muccc/moodlamp-rf/board/buslamp-r4_reverse_ESP.brd

## EAGLE design board/buslamp-r4_reverse_ESP.brd (2017-02-21)

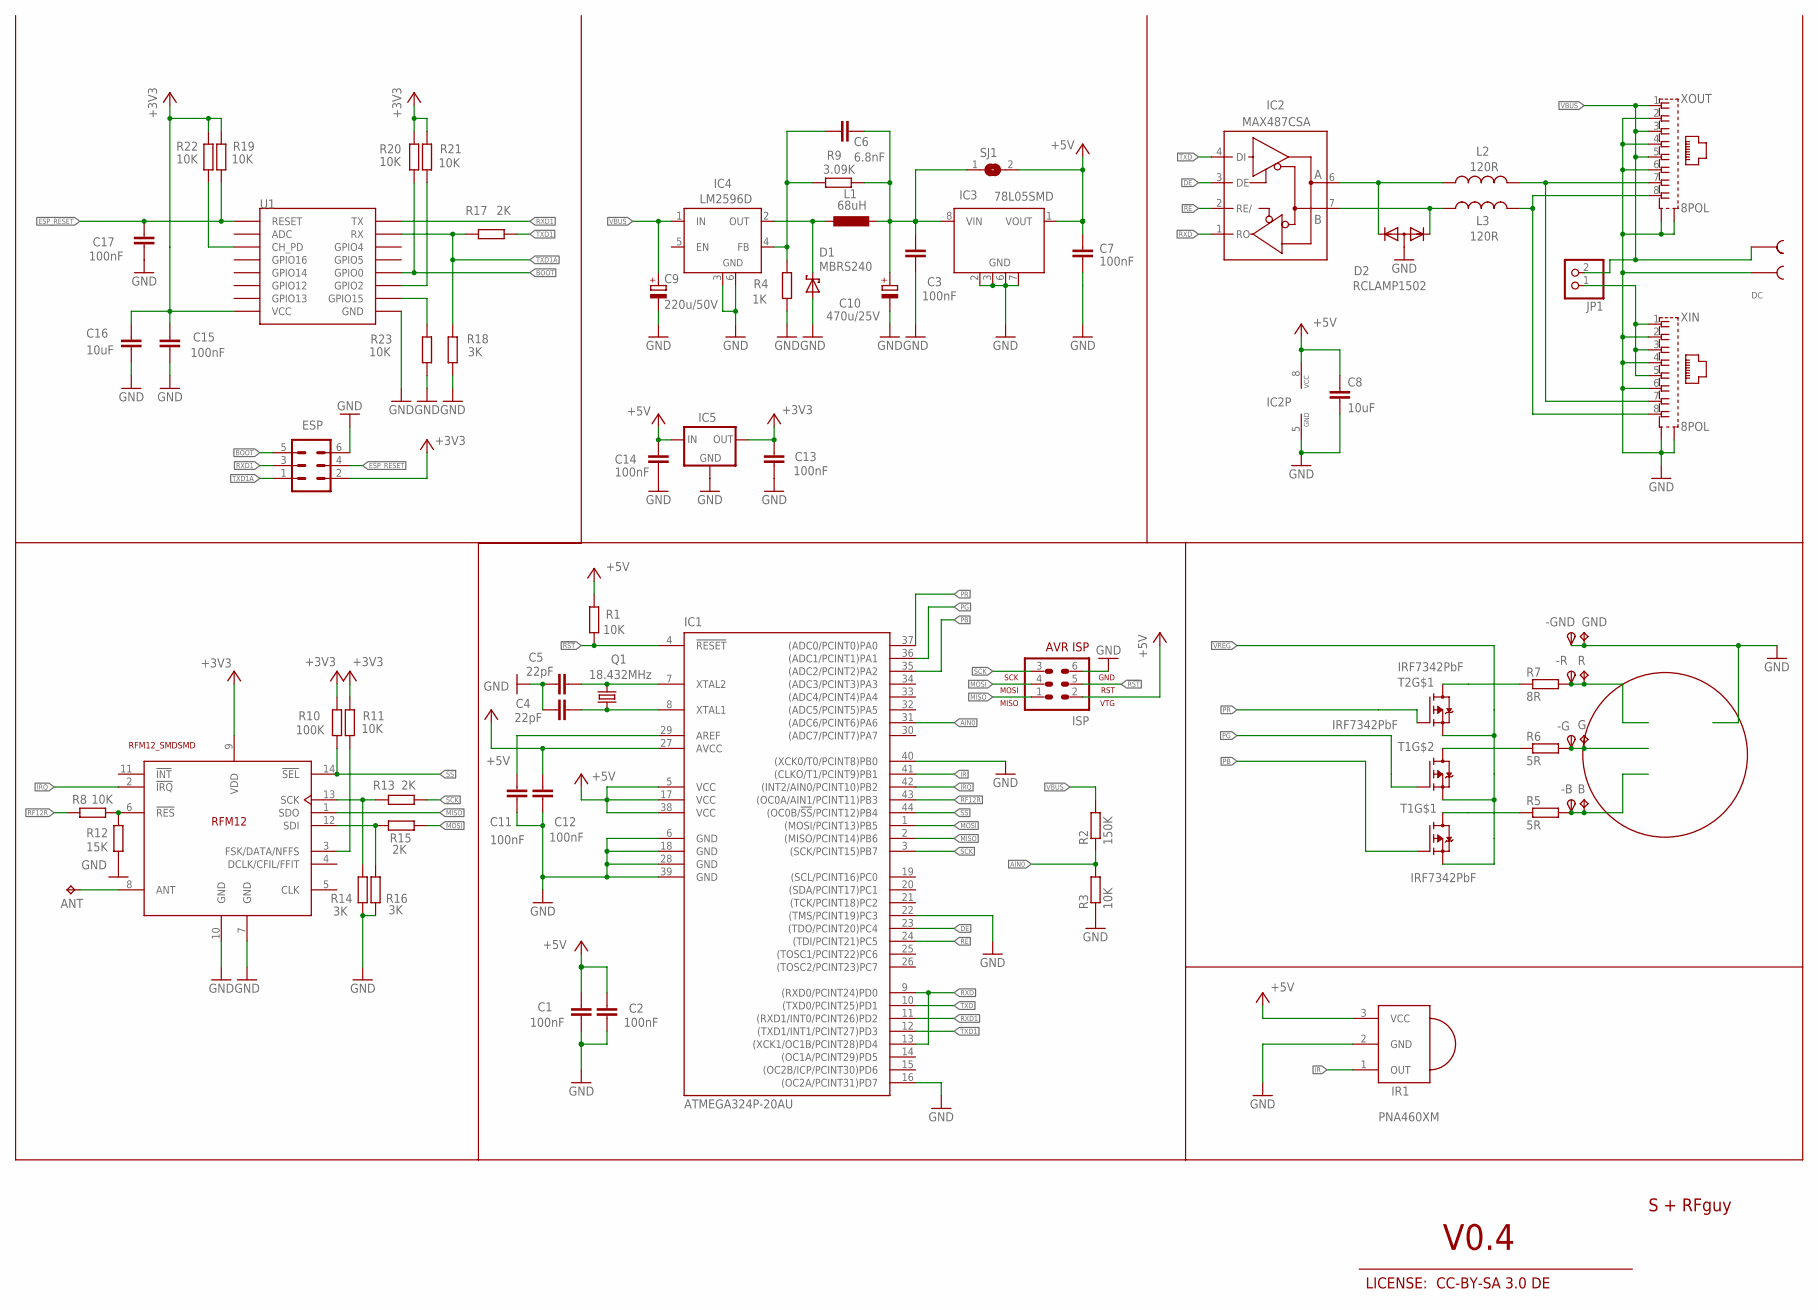
[picture p1: schematic buslamp-r4_reverse_ESP.sch]

Parts:
-B: TPSTP212R; TP212R
-G: TPSTP212R; TP212R
-GND: TPSTP212R; TP212R
-R: TPSTP212R; TP212R
ANT: TPPAD1-13; P1-13
B: TPPAD1-13; P1-13
C1, C2, C3, C7: 100nF; C0805K
C4, C5: 22pF; C0805K
C6: 6.8nF; C0805K
C8, C16: 10uF; C1210
C9: 220u/50V; UD-10X10_NICHICON
C10: 470u/25V; UD-10X10_NICHICON
C11, C12, C13, C14, C15, C17: 100nF; C0805
D1: MBRS240; SMB
D2: RCLAMP1502; SOT23
DC: STL-266-2
ESP: MA03-2
G: TPPAD1-13; P1-13
GND: TPPAD1-13; P1-13
IC1: ATMEGA324P-20AU; TQFP44
IC2: MAX487CSA; SO08
IC3: 78L05SMD; SO08
IC4: LM2596D; TO263-5
IC5: MCP1700SOT23; SOT23
IR1: PNA460XM
ISP: AVR-ISP-6
JP1: PINHD-1X2; 1X02
L1: 68uH; PIS4728
L2, L3: 120R; L0603
Q1: 18.432MHz; HC49/S
R: TPPAD1-13; P1-13
R1, R8, R11, R19, R20, R21, R22, R23: 10K; M0805
R2: 150K; R0805
R3: 10K; R0805
R4: 1K; M0805
R5, R6: 5R; 0617/17
R7: 8R; 0617/17
R9: 3.09K; M0805
R10: 100K; M0805
R12: 15K; M0805
R13, R15, R17: 2K; M0805
R14, R16, R18: 3K; M0805
RF1: RFM12_SMDSMD; RFM12
SJ1: SJ
T1, T2: IRF7342PbF; SO08-IRF
U1: ESP12SMD; ESP12-SMD
U$2: KK-STERN; STERN
XIN: 8POL
XOUT: 8POL

Connections:
!RE: IC1.24 ((TDI/PCINT21)PC5), IC2.2 (RE/)
!RST: IC1.4 (!RESET), ISP.5, R1.1
+3V3: C13.2, C15.2, C16.1, ESP.2, IC5.2 (OUT), R10.1, R11.1, R19.1, R20.1, R21.1, R22.1, RF1.9 (VDD), U1.VCC
+5V: C1.1, C2.1, C7.1, C8.1, C12.2, C14.2, IC1.5 (VCC), IC1.17 (VCC), IC1.27 (AVCC), IC1.38 (VCC), IC2.8 (VCC), IC3.1 (VOUT), IC5.3 (IN), IR1.3 (VCC), ISP.2, R1.2, SJ1.2
A: L2.2, XIN.7, XOUT.7
AIN0: IC1.31 ((ADC6/PCINT6)PA6), R2.1, R3.2
B: L3.2, XIN.8, XOUT.8
BOOT: ESP.5, R20.2, U1.GPIO0
DE: IC1.23 ((TDO/PCINT20)PC4), IC2.3 (DE)
ESP_RESET: C17.2, ESP.4, R19.2, U1.RESET
G: -G.TP, G.TP, R6.2
GND: -GND.TP, C1.2, C2.2, C3.2, C4.1, C5.1, C7.2, C8.2, C9.-, C10.-, C11.1, C12.1, C13.1, C14.1, C15.1, C16.2, C17.1, D1.A, D2.3 (A), DC.P$3, ESP.6, GND.TP, IC1.6 (GND), IC1.16 ((OC2A/PCINT31)PD7), IC1.18 (GND), IC1.22 ((TMS/PCINT19)PC3), IC1.28 (GND), IC1.39 (GND), IC1.40 ((XCK0/T0/PCINT8)PB0), IC2.5 (GND), IC3.2 (GND), IC3.3 (GND), IC3.6 (GND), IC3.7 (GND), IC4.3 (GND), IC4.6 (GND), IC5.1 (GND), IR1.2 (GND), ISP.6, R3.1, R4.2, R12.2, R14.2, R16.2, R18.2, R23.2, RF1.7 (GND), RF1.10 (GND), U1.GND, XIN.2, XIN.4, XIN.6, XIN.S1, XIN.S2, XOUT.2, XOUT.4, XOUT.6, XOUT.S1, XOUT.S2
IR: IC1.41 ((CLKO/T1/PCINT9)PB1), IR1.1 (OUT)
IRQ: IC1.42 ((INT2/AIN0/PCINT10)PB2), RF1.2 (!IRQ)
MISO: IC1.2 ((MISO/PCINT14)PB6), ISP.1, RF1.1 (SDO)
MOSI: IC1.1 ((MOSI/PCINT13)PB5), ISP.4, R15.2
unnamed: R7.1, T2.7 (D), T2.8 (D)
unnamed: R8.2, R12.1, RF1.6 (!RES)
unnamed: C6.1, IC4.4 (FB), R4.1, R9.2
unnamed: R6.1, T1.5 (D), T1.6 (D)
unnamed: R5.1, T1.7 (D), T1.8 (D)
unnamed: -B.TP, B.TP, R5.2
unnamed: R13.1, R14.1, RF1.13 (SCK)
unnamed: R15.1, R16.1, RF1.12 (SDI)
unnamed: ANT.TP, RF1.8 (ANT)
unnamed: D1.C, IC4.2 (OUT), L1.1
unnamed: D2.2 (K2), IC2.6 (A), L2.1
unnamed: D2.1 (K1), IC2.7 (B), L3.1
unnamed: R11.2, RF1.3 (FSK/DATA/NFFS)
unnamed: R21.2, U1.GPIO2
unnamed: R22.2, U1.CH_PD
unnamed: R23.1, U1.GPIO15
unnamed: C11.2, IC1.29 (AREF)
PB: IC1.35 ((ADC2/PCINT2)PA2), T1.2 (G)
PG: IC1.36 ((ADC1/PCINT1)PA1), T1.4 (G)
PR: IC1.37 ((ADC0/PCINT0)PA0), T2.2 (G)
R: -R.TP, R.TP, R7.2
RF12R: IC1.43 ((OC0A/AIN1/PCINT11)PB3), R8.1
RXD: IC1.9 ((RXD0/PCINT24)PD0), IC1.13 ((XCK1/OC1B/PCINT28)PD4), IC2.1 (RO)
RXD1: ESP.3, IC1.11 ((RXD1/INT0/PCINT26)PD2), U1.TXD0 (TX)
SCK: IC1.3 ((SCK/PCINT15)PB7), ISP.3, R13.2
SS: IC1.44 ((OC0B/!SS!/PCINT12)PB4), R10.2, RF1.14 (!SEL)
TXD: IC1.10 ((TXD0/PCINT25)PD1), IC2.4 (DI)
TXD1: IC1.12 ((TXD1/INT1/PCINT27)PD3), R17.2
TXD1A: ESP.1, R17.1, R18.1, U1.RXD0 (RX)
VBUS: C9.+, DC.P$4, IC4.1 (IN), JP1.2, R2.2, XOUT.1, XOUT.3, XOUT.5
VBUSOUT: JP1.1, XIN.1, XIN.3, XIN.5
VREG: C3.1, C6.2, C10.+, IC3.8 (VIN), L1.2, R9.1, SJ1.1, T1.1 (S), T1.3 (S), T2.1 (S)
XTAL1: C5.2, IC1.7 (XTAL2), Q1.2
XTAL2: C4.2, IC1.8 (XTAL1), Q1.1

Notes on the sheet:
S + RFguy
V0.4
LICENSE: CC-BY-SA 3.0 DE

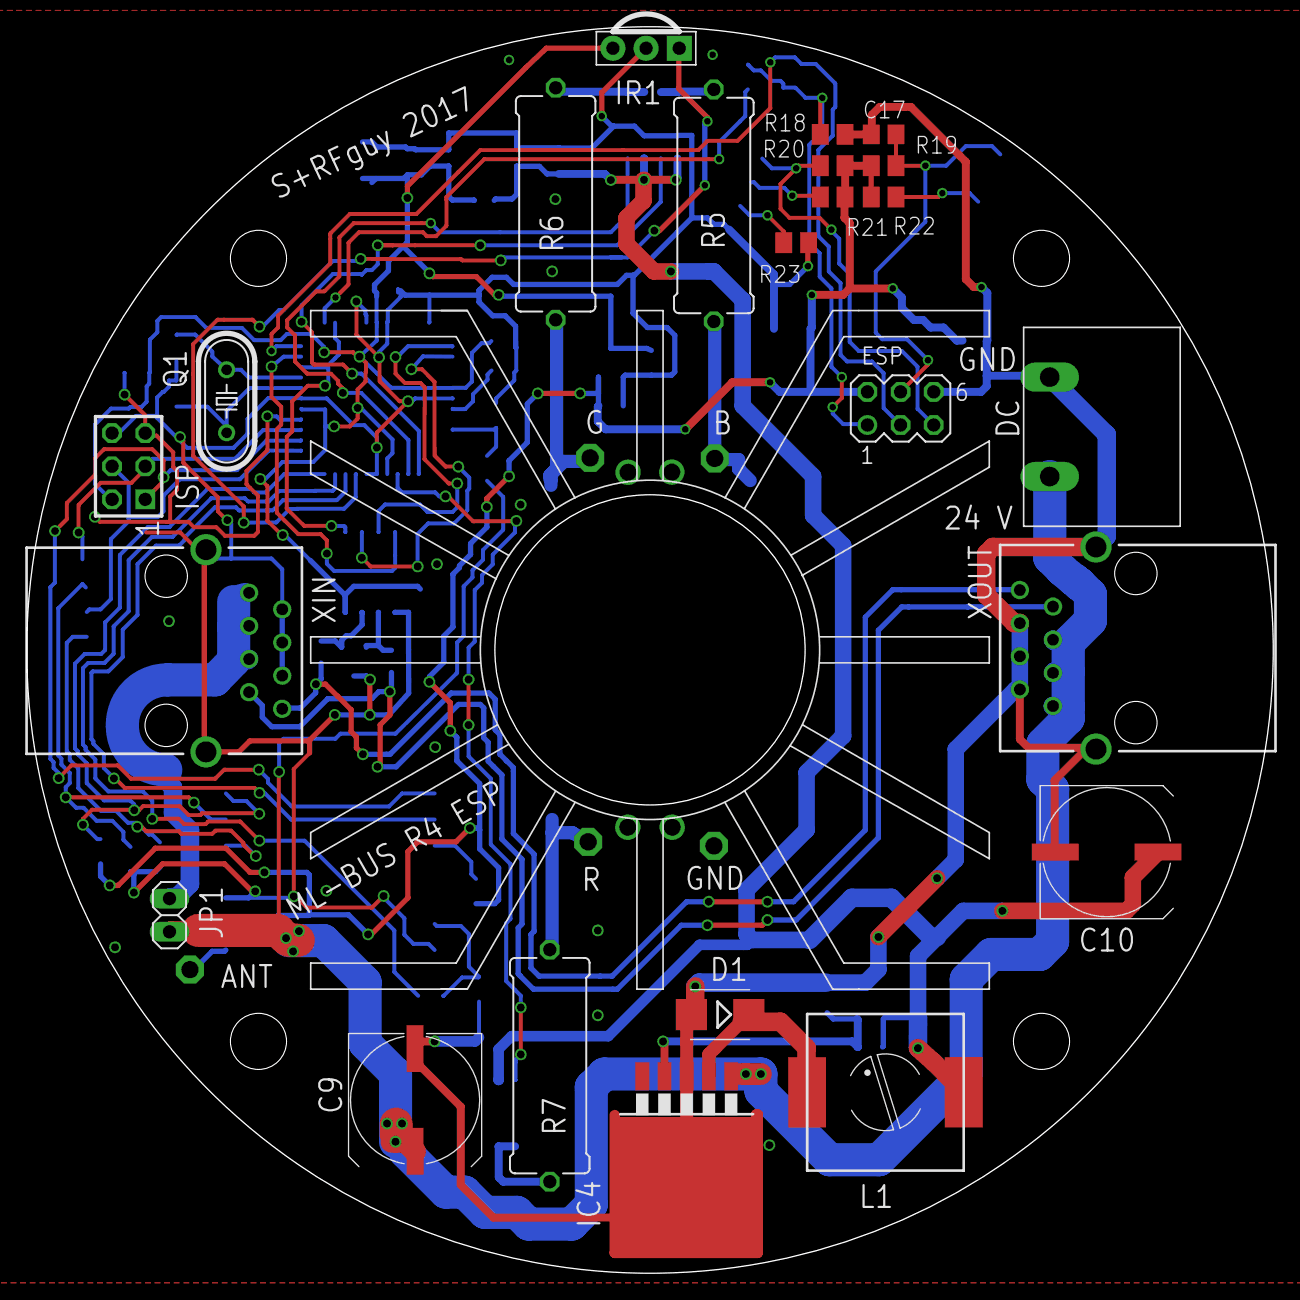
[picture p2: board buslamp-r4_reverse_ESP.brd from above]

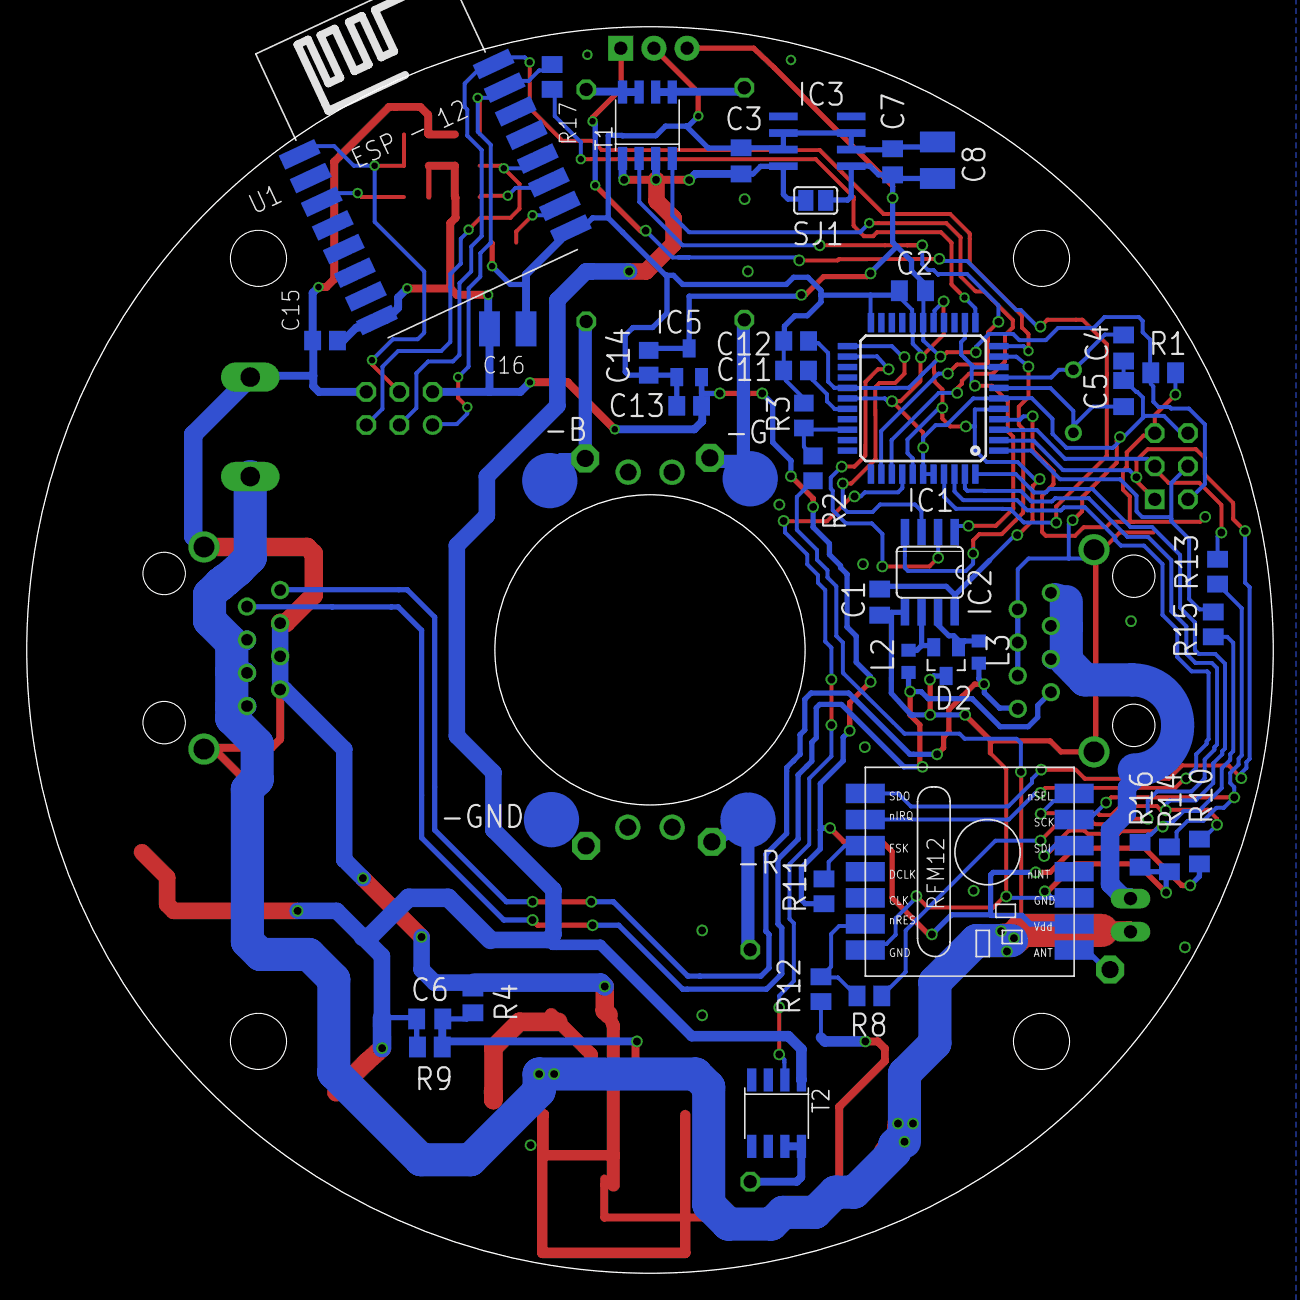
[picture p3: board buslamp-r4_reverse_ESP.brd from below]

Board: 2 copper layers, 95.5 x 95.5 mm, 73 parts (44 on the bottom side), 50 nets.
