muccc/moodlamp-rf/(commit log)

2016-01-20 Reverse Variante für DX Leds
    [buslamp-r4_reverse.brd, buslamp-r4_reverse.sch]
2017-02-21 Bus MoodLamp R4 for Reverse DX LED with P-Kanal FET and ESP8266-12 WLAN Bridge, Schematic cleanup, 100 pieces ordered by seeed today
    [buslamp-r4_reverse_ESP.brd, buslamp-r4_reverse_ESP.sch]
